riosil/EdgeLED/images/controller_options.jpg

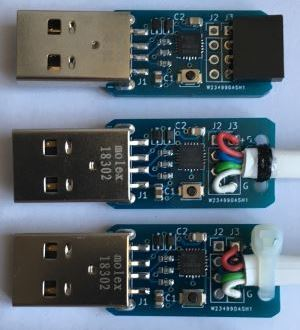
images/controller_options.jpg
