riosil/EdgeLED/images/usb_board.jpg

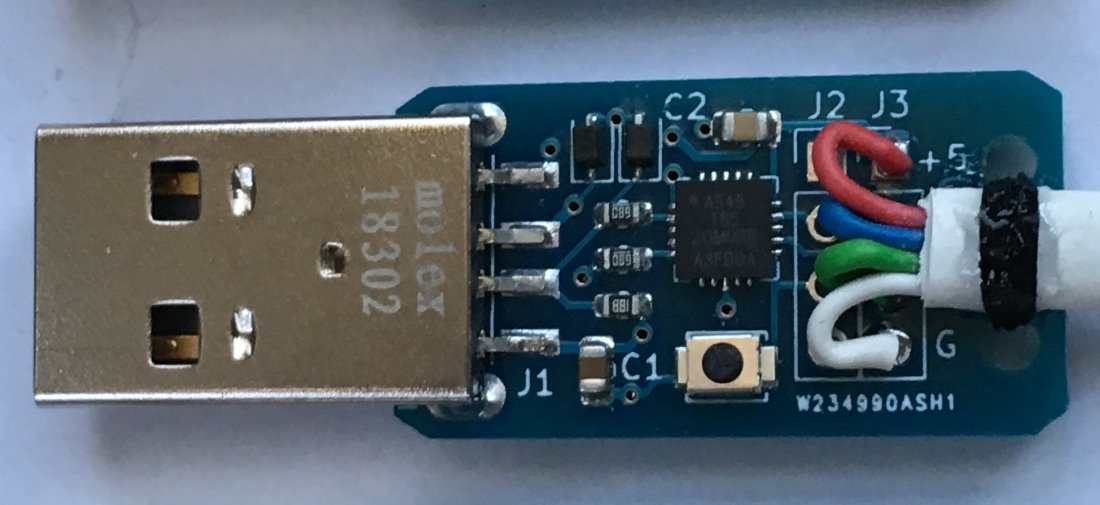
images/usb_board.jpg
