riosil/EdgeLED/KiCAD/schematic.pdf

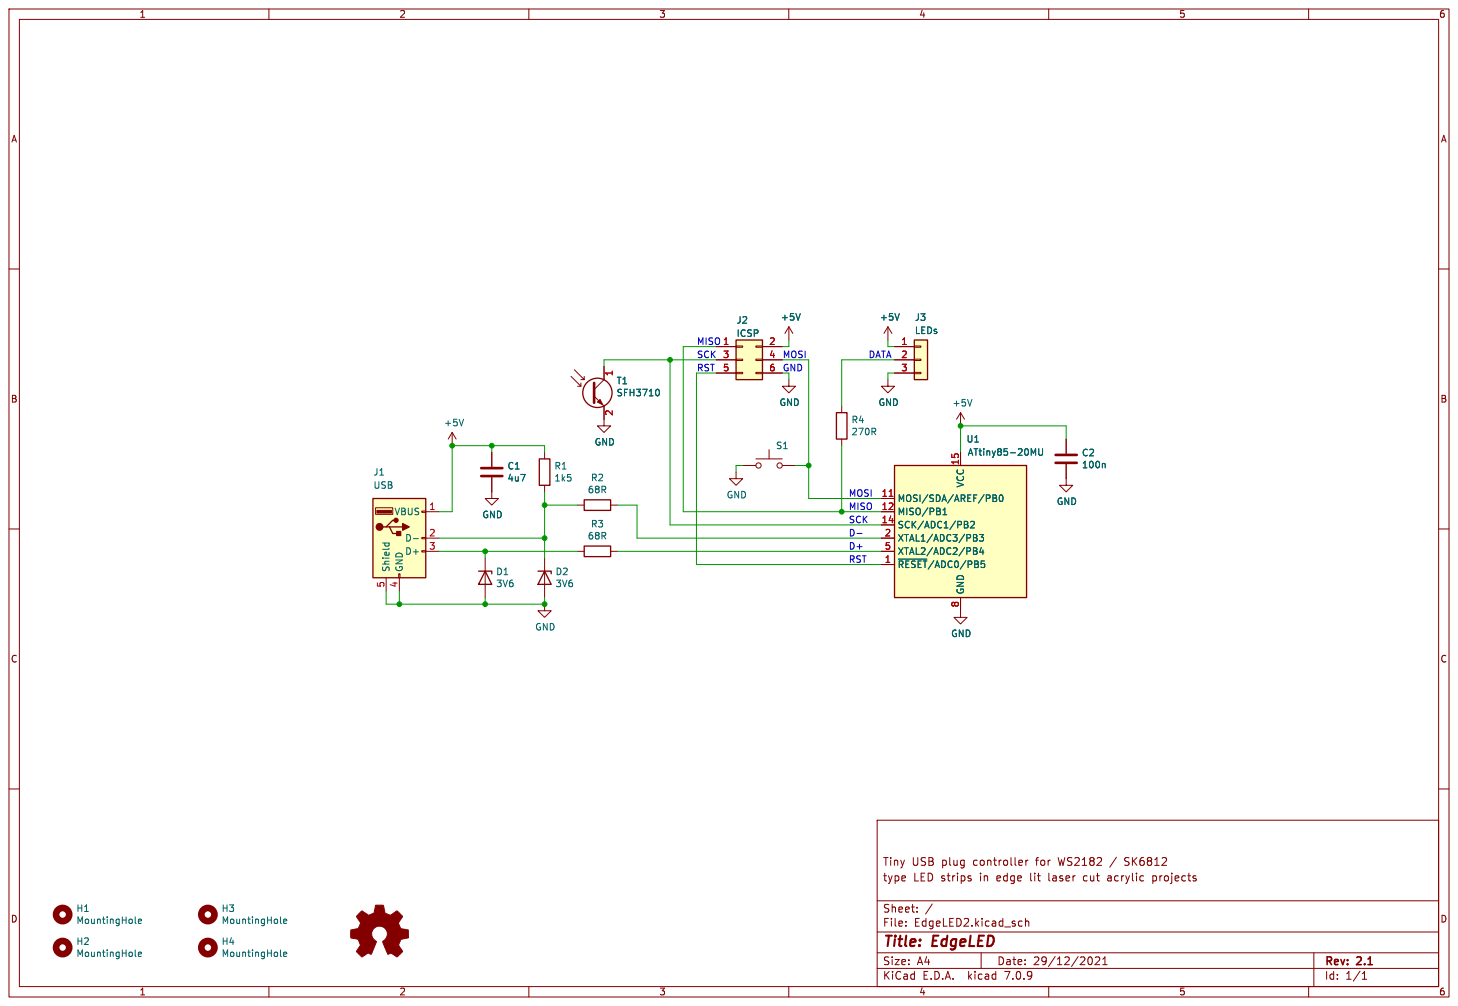
[picture p7: page 1]
