riosil/EdgeLED/images/sign_makespace.jpg

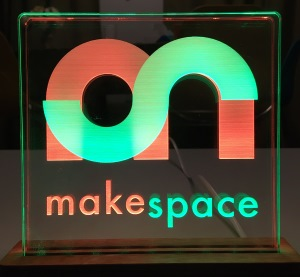
images/sign_makespace.jpg
