riosil/EdgeLED/images/manual_fix_v2.jpg

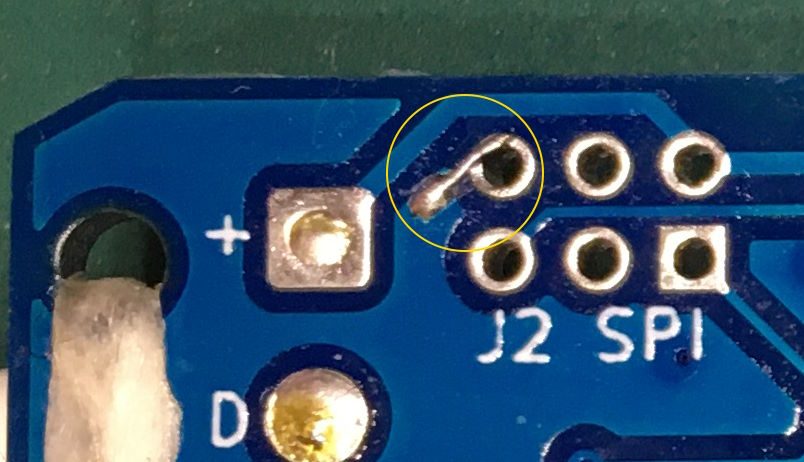
images/manual_fix_v2.jpg
