riosil/EdgeLED/(threads)

Thread 1 (2023-12-01):

How to procure hardware?

miguelmorin, 2023-12-01:
Hello Steven! This is Miguel from Makespace. Thanks for making this public!

Are you selling the hardware: wood, LED and controller?

If not, I would like to procure some. The README says ATtiny85 but the image shows a different one. Could you please include a list of gear to buy to replicate the project?

riosil, 2023-12-02:
Thanks Miguel, no plans to sell atm but I'll make a few bare v2 PCBs available in MakeSpace (free). I was hoping my demo projects in the 'space would inspire more edge lit display projects

Profiles to make the wood parts are in the laser_cutter folder. For LEDs, search AliExpress for SK6812MINI or WS2812B, choose spacing and size to suit project.

I just generated a BoM (in the KiCAD folder). This project has only ever used the ATtiny85.

miguelmorin, 2023-12-09:
Never mind: in the `CAM` directory, I see the README that suggests JLCPCB. I tried it and it works. The Bill of Materials also works and JLCPCB can source most of them and assemble them too. So, for the electronics, it's as simple as that at https://jlcpcb.com/ .

ATtiny85 is currently out of inventory. So I'll try again in a few months. Also, for anyone in the future, the "Pick&Place" CPL file is `EdgeLED2-top-pos.csv`.

miguelmorin, 2024-03-05:
Thanks for your help with the PCB; unfortunately JLCPCB didn't have them in stock when I wanted to buy them, and I tested with some LEDs and the edge lighting doesn't seem to work well with my engravings, either because the acrylic is too thin or because the engraving of a photographic bitmap doesn't work well. If and when you put your PCB and construction on the market, please let me know!

Closed 2023-12-09.
