riosil/EdgeLED/(commit log)

2020-05-24 Add LED image
2020-05-24 Added laser cutting profile for bases
2021-04-09 LaserScript files for Makespace laser cutters
2023-12-02 V2 board
2023-12-02 V2 board programming
2023-12-02 KiCAD files and BOM
    [bill_of_material.csv]
2023-12-04 fix missing ICSP connector ground
    [bill_of_material.csv]
2023-12-04 text cleanup, more CAM files
    [bill_of_material_jlcpcb.csv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]
2024-08-26 new IDE board core repos
